jovanSlavujevic96/EMI_SW-HW/doc/pic/1633297166608.jpg

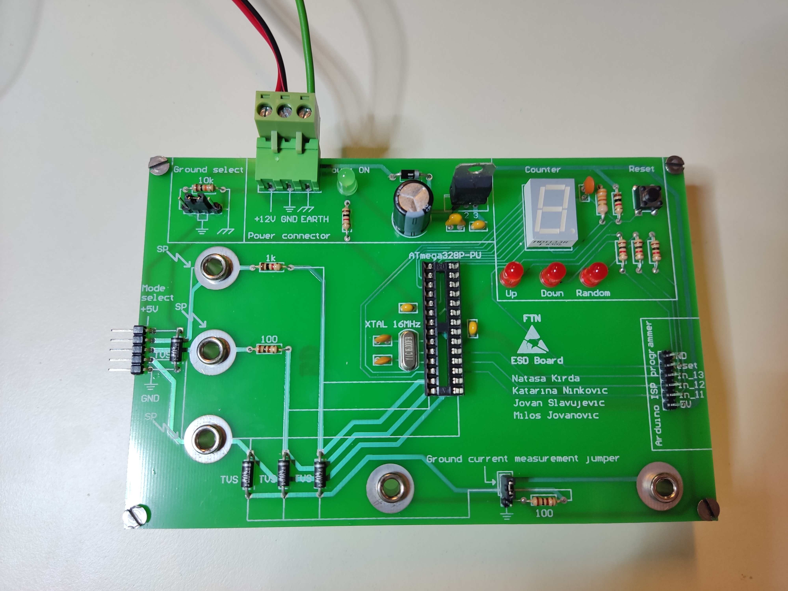
doc/pic/1633297166608.jpg
