jovanSlavujevic96/EMI_SW-HW/doc/PCB/PCB layout.jpg

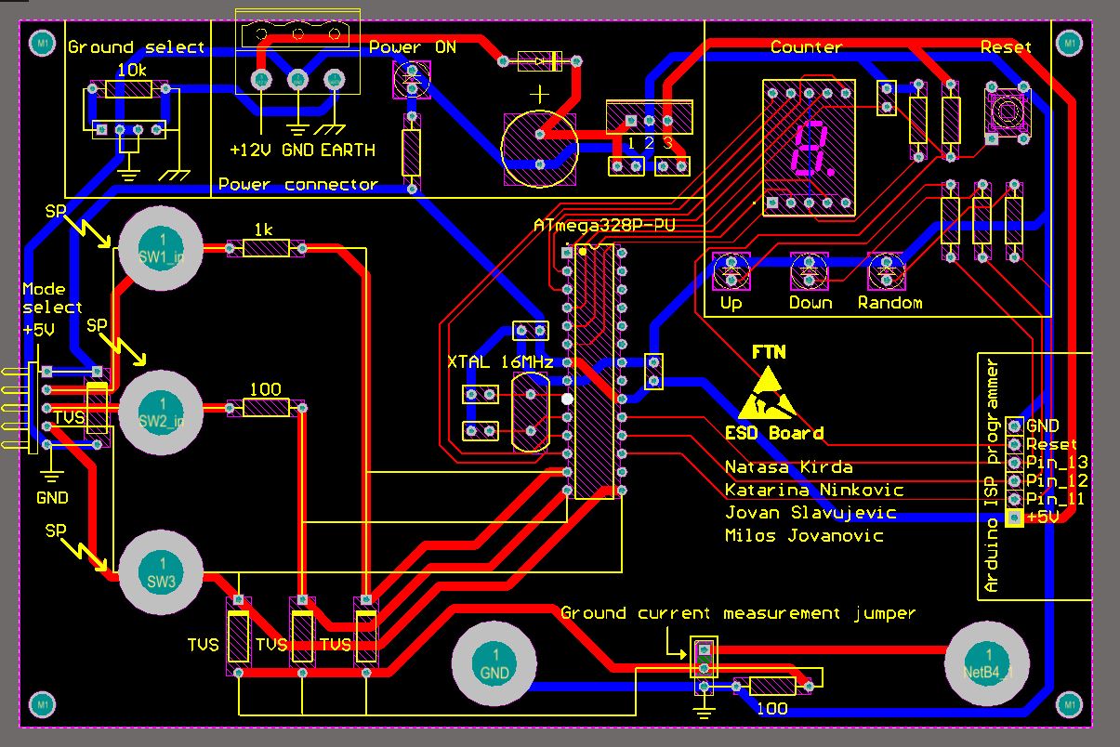
doc/PCB/PCB layout.jpg
