jovanSlavujevic96/EMI_SW-HW/doc/PCB/PCB 3D 01.jpg

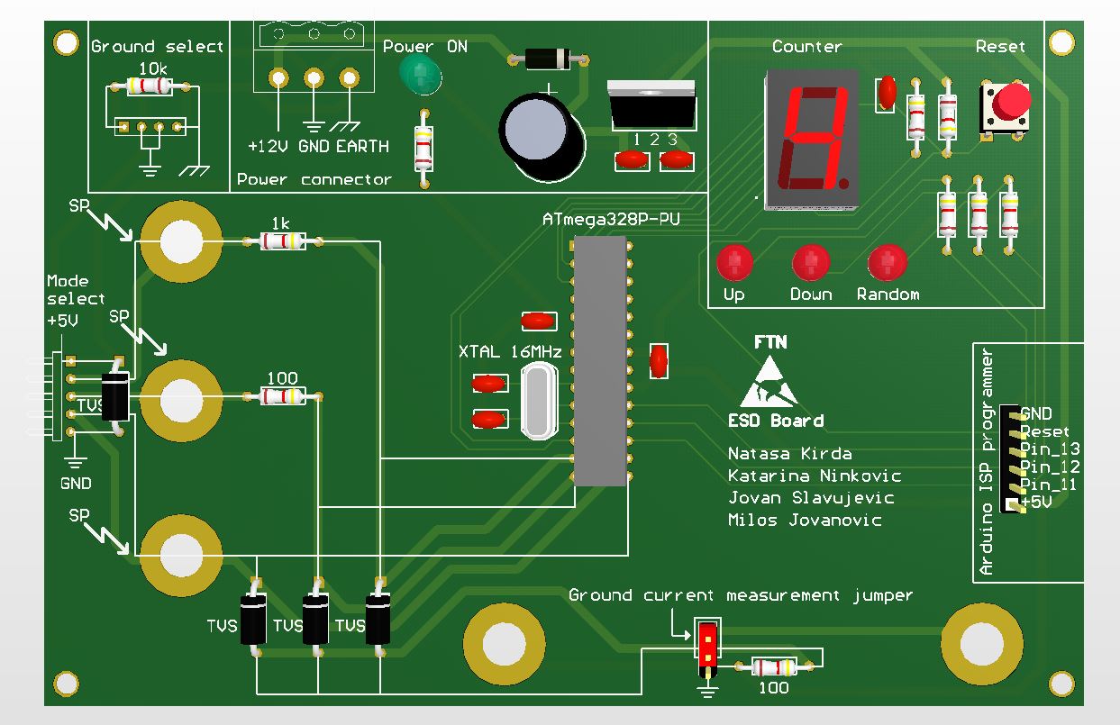
doc/PCB/PCB 3D 01.jpg
