jovanSlavujevic96/EMI_SW-HW/other/EMI domaci/ac_analysis_settings_2.png

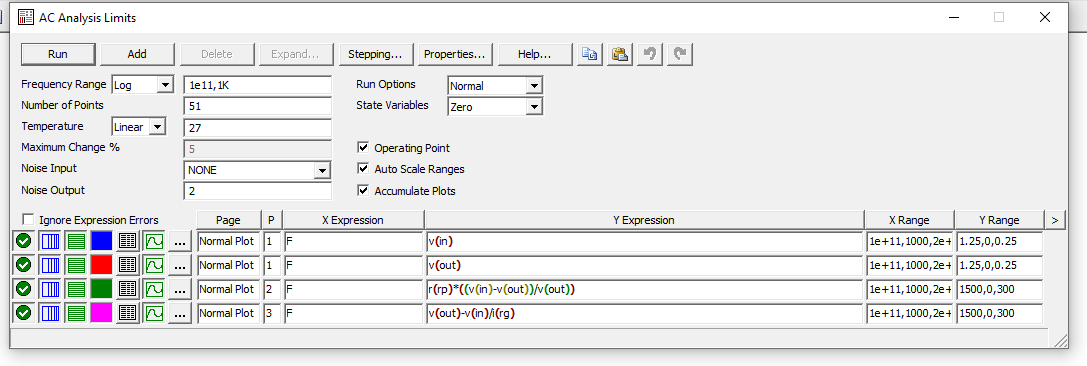
other/EMI domaci/ac_analysis_settings_2.png
