jovanSlavujevic96/EMI_SW-HW/other/EMI domaci/graph1.BMP

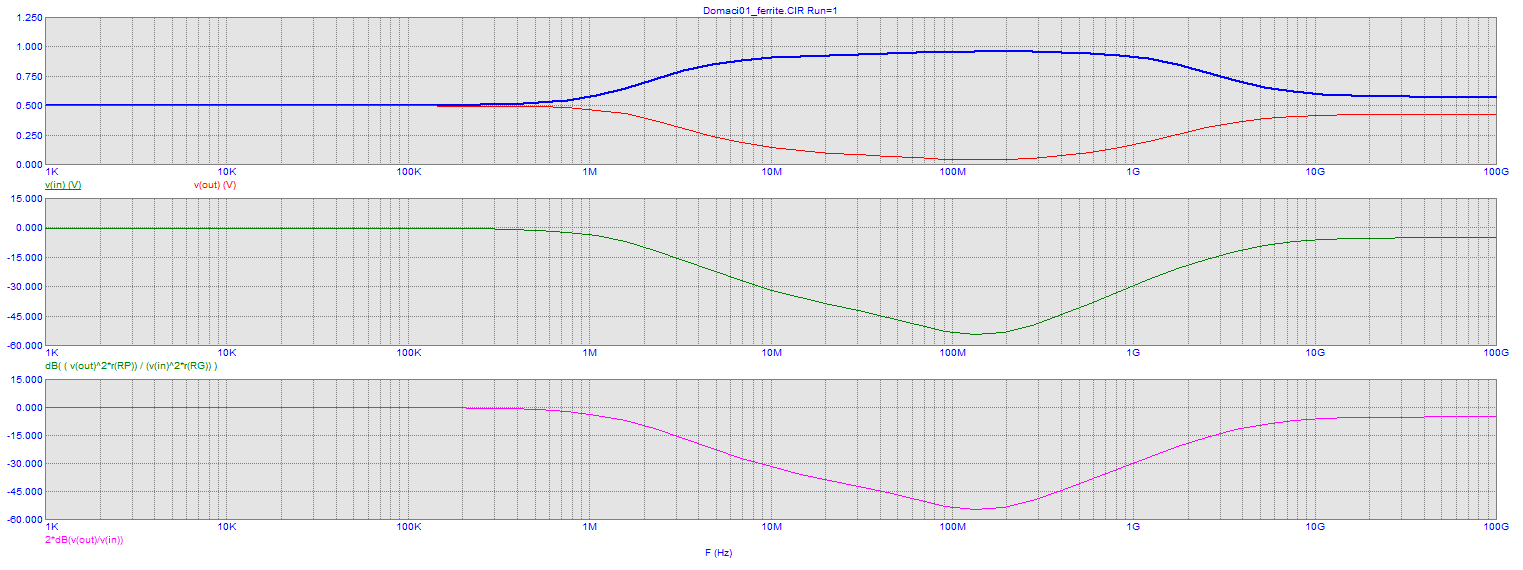
other/EMI domaci/graph1.BMP
