jovanSlavujevic96/EMI_SW-HW/(list of files, drawings)

Other design files:
PCB_HW/EMI_EMC_PCB1.PcbDoc
PCB_HW/EMI_EMC_project.PrjPcb
PCB_HW/EMI_EMC_schematic.SchDoc
PCB_HW/EMI_PCB_lib.PcbLib
PCB_HW/EMI_SCH_lib.SchLib
