jovanSlavujevic96/EMI_SW-HW/(commit log)

2021-10-03 - Final implementation of SW module - Added PCB Design of board
    [EMI_EMC_PCB1.PcbDoc, EMI_EMC_project.PrjPcb, EMI_EMC_schematic.SchDoc, EMI_PCB_lib.PcbLib, EMI_SCH_lib.SchLib]
2021-10-03 - Added Block diagram and flow chart
2021-10-06 - Updated documentation & PCB project
    [EMI_EMC_PCB1.PcbDoc, EMI_EMC_project.PrjPcb, EMI_EMC_schematic.SchDoc, EMI_PCB_lib.PcbLib, EMI_SCH_lib.SchLib]
